srijandas2025/ESP32-S3-Internet-Radio/secrets.example.h

// Copy this file to "secrets.h" (same folder) and fill in your WiFi details.
// secrets.h is in .gitignore so your password is never uploaded.
#define WIFI_SSID "your_wifi_name"
#define WIFI_PASSWORD "your_wifi_password"
