srijandas2025/ESP32-S3-Internet-Radio/(commit log)

2026-10-27 Initial commit: ESP32-S3 internet radio
2026-10-27 Enhance README with power supply advice
    Updated README with additional power supply recommendation and removed license section.
